pierrotm777/SoundModule_Teensy4.0-version/README.md

# Multi Sounds for RC boat (or Truck, Tank, Car and Plane)

## Credits
Based on a croby-b's code idea and powered by Rc-Navy libraries.  

## Outline of the documentation
1. Introduction (this page)
1. [Xany Compatibility](Xany_Compatibility.md)
1. [Xany Serial Commands](Xany_Mode.md)
1. [Buttons Serial Commands](Buttons_Mode.md)
1. [Wiring Sound module](Wiring_Module.md)
1. [Sd Card Structure](SD_Card_Structure.md)

## Introduction
For build this module we use the [Teensy-Variable-Playback](https://github.com/newdigate/teensy-variable-playback) library with a Teensy 4.0.  

This Sound Module is primarily intended for model boats, trucks, tractors, tanks, and backhoe loaders, but can also be configured for aircraft.  

This module can:  
- vary the engine sound based on engine speed.  
- use any type of engine sound (more than 10 are already available).  
- 4 simultaneous sounds in addition to the engine sound.  
- 16 pre-programmable sounds.  
- 4 pre-programmable random sounds.  
- volume control via the touchscreen, a button on the transmitter, or two buttons on a 10-button keypad.  
- Smoke system management (tank + air pump).  
- 5 RGB LEDs (multicolored).  
- Controllable via touchscreen or 10-button keypad.  
- 2W audio amplifier (useful for small boats or testing) or 18W.  
- Controllable via a receiver with PWM, CPPM, SBUS (Frsky or others), IBUS (Flysky), SRXL (Multiplex), SUMD (Graupner), JETI, or CRSF (ExpressLRS/TBS) output.  
- ESC output management to adjust engine sound (adjustable acceleration and deceleration).  
- 4 alarms, one of which is reversible to detect the absence of liquid, for example.  
- Telemetry feedback of the Teensy's temperature as well as the motor battery voltage for Frsky (Hub or S-Port), Flysky (Ibus), ExpressLRS/TBS (CRSF).  
- Module management/configuration via its serial interface.  
- Module configuration backup on an SD card.  

SD Card:  
- This contains all the sounds and the sound module's configuration.  

Power Supply:  
The module is powered by a Lipo battery for a maximum of 2s to 3s.  
It is possible to enable or disable the module's power supply using a relay or other solution via the On/Off connector.  

A custom printed circuit board has been created. We are currently at version v1.2, visible above.  
A v1.3 version is planned, which will include an additional option via an I2C interface.  
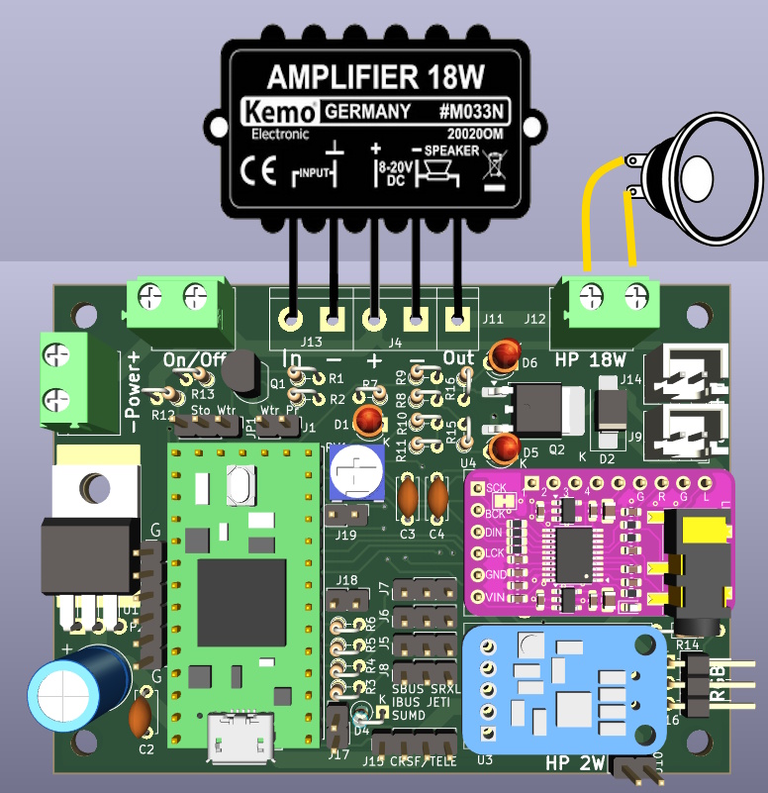
[picture p1: ampli18w.jpg]
  

Creating a new engine sound:  
Simply retrieve the desired engine sound to create a startup sound, an operating sound, and a shutdown sound.  
The more realistic the original sound, the more appealing the result will be.  
So, when the engine starts, you hear the typical sound of an engine hesitating, followed by the normal sound with variations in frequency and speed.  
Then, when the engine stick returns to center, after 5 to 10 seconds (adjustable), the shutdown sound is played.  

## Two modes
Two modes are possibles:
- Use [X-Any/BURC encoder](https://p-loussouarn-free-fr.translate.goog/arduino/exemple/RCUL/RCUL.html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) fonctions by RC-Navy, thanks to him.  
- Use [Buttons Keypad](http://p.loussouarn.free.fr/projet/MS8-V2/MS8-V2.html#Keyboard) fonctions by RC-Navy, thanks to him.  
- The module read all WAV sounds from a SD card (from /ENGINES folder).  

You can find more informations on the Sound Module:
- [french manual](https://github.com/pierrotm777/SoundModule_Teensy4.0-version/blob/main/Module_Son_Manuel_Utilisateur.pdf).  
- [english manual (TODO)](https://github.com/pierrotm777/SoundModule_Teensy4.0-version/blob/main/Module_Son_Manuel_Utilisateur.pdf).    

### X-Any mode
This mode decode the X-Any/BURC stream.  

Depending on the receiver used, it's possible to connect the sound module in different ways:  
- PWM  
- CPPM  
- SBUS (without inverter)  
- IBUS  
- SUMD  
- SRXL  
- JETIEX  
- CRSF  

A [BURC encoder](https://github.com/pierrotm777/BURC_Encoder) or a [LVGL ESP32 S3 Screen](https://github.com/pierrotm777/ESP32-BURC-Screen) is connected on a Handset by CPPM or SBUS.     

These X-Any/BURC coder use the **trainer port** as slave and use up to 2 channels (for the Sound Module) as X-Any fonctions.  
X-Any inject three additionals RC channels to a CPPM or SBUS frame for transport messages over these additionals channels.  
At reception side, these messages are extracted from these 2 channels corresponding to the additionals channels.  
These 2 channels are used to transport 2 messages containing the status of a set of switches or set of sound in the Sound Modul case.  

### Buttons mode
This mode use a keyboard with 10 buttons (8 buttons + 2 for volume sounds).  
It's a good solution for old rc transmitters that do not have a training input.  
This keyboard is connected on a free input channel in place of a potentiometer.  
This mode accept only 8 sounds.  
The buttons 9 and 10 up or down the volume's sounds.  

<table cellspacing=0>
  <tr>
    <td align=center width=400><a href="https://github.com/pierrotm777/SoundModule_Teensy4.0-version/blob/main/10ButtonsKeyboard.md">Sound Module</a><br><b>KeyBoard 10 buttons</td>
  </tr>
</table>

Depending on the receiver used, it's possible to connect the sound module in different ways:  
- PWM  
- CPPM  
- SBUS (without inverter)  
- IBUS  
- SUMD  
- SRXL  
- JETIEX  
- CRSF  

## PCB versions
<table cellspacing=0>
  <tr>
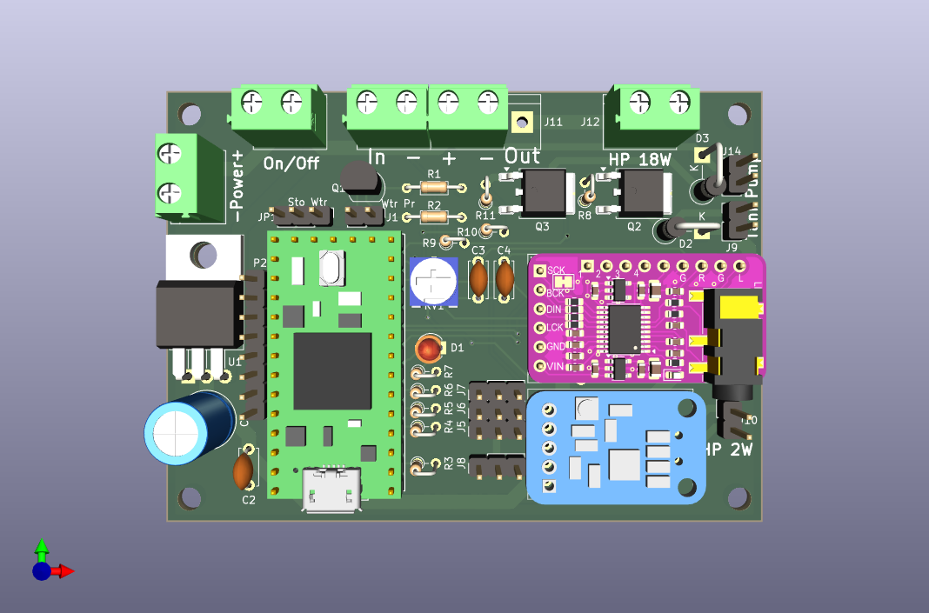
[picture p2: Hardware/V1.0/Sound_Myca_Teensy-Top3d_v1.0.png]
Sound Module v1.0 Sound Module
    <td align=center width=400><br><b>V1.0 (deprecated)</td>
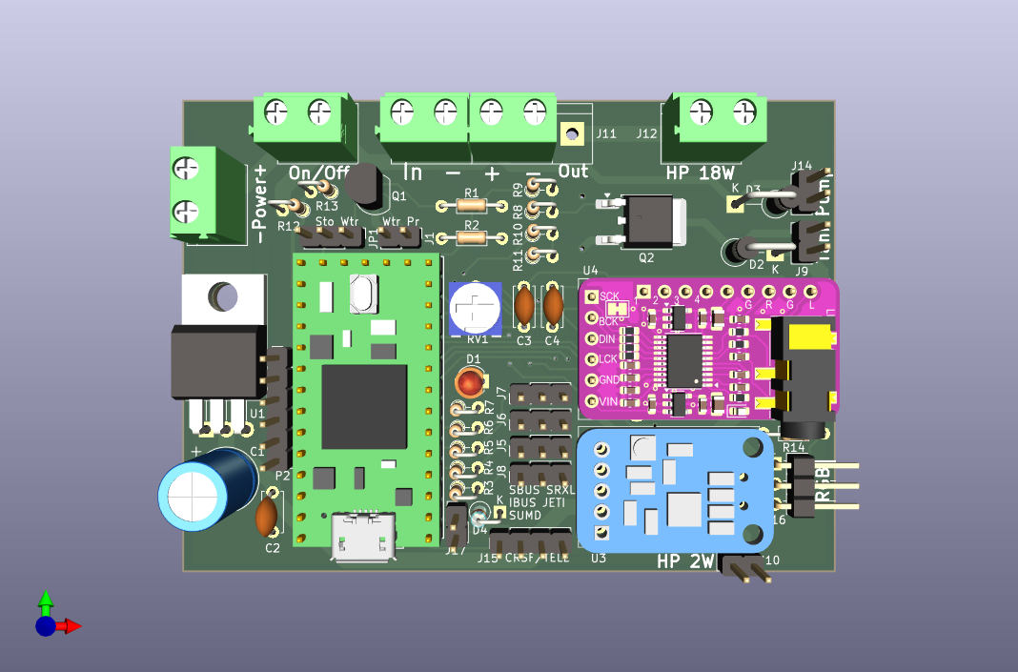
[picture p3: Hardware/V1.1/Sound_Myca_Teensy_Top_v1.1.png]
Sound Module v1.1 Sound Module
    <td align=center width=400><br><b>V1.1 (deprecated)</td>
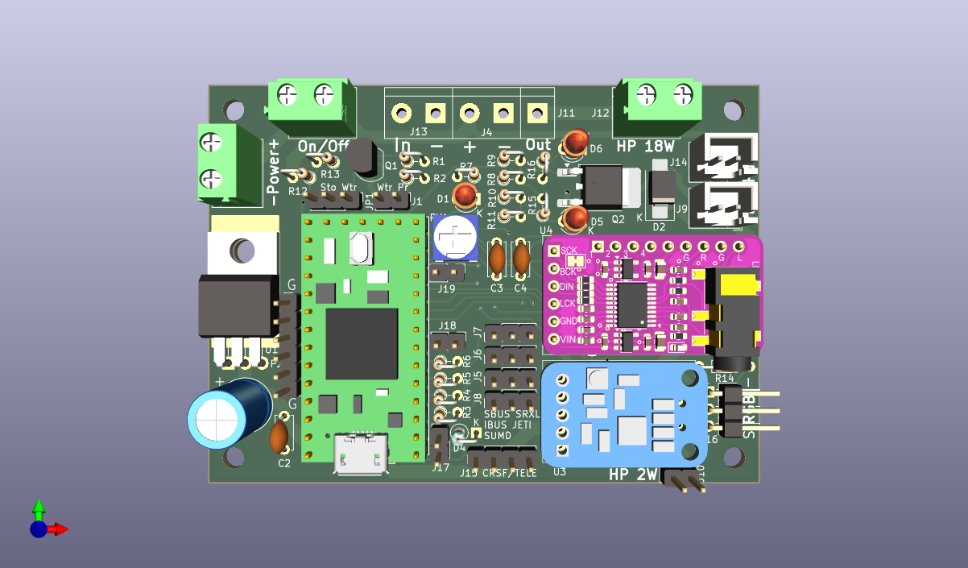
[picture p4: Hardware/V1.2/Sound_Myca_Teensy_Top_v1.2.png]
Sound Module v1.2 Sound Module
    <td align=center width=400><br><b>V1.2</td>
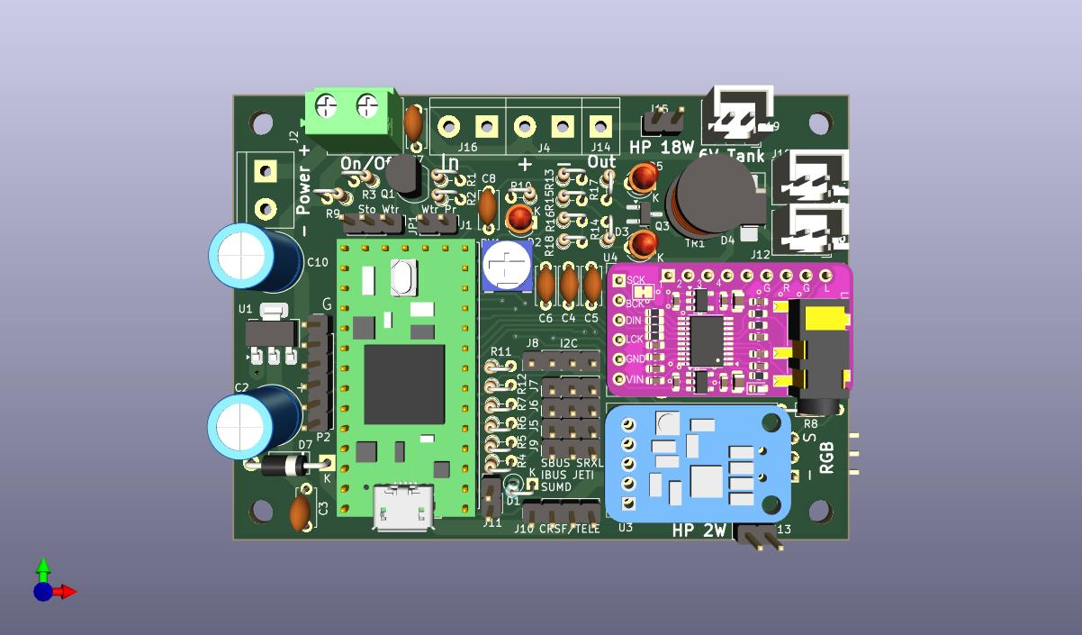
[picture p5: Hardware/V1.3/Sound_Myca_Teensy_Top.jpg]
Sound Module v1.3 Sound Module
	<td align=center width=400><br><b>V1.3</td>
  </tr>
</table>

## WAV Sounds
Play **16-bit PCM 44100Hz Stereo** WAV audio samples at variable playback rates on Teensy.  
- Note : this library only works with signed 16-bit integer samples. Floating point samples will not play.  
- For best performance, use SDXC UHS 30MB/sec Application Performance Class 2 (A2) class micro SD-card.  

### Sounds Motor
It's possible to select several motors.  
The module can list all sound's motor found into the SD card [ENGINES folder](https://github.com/pierrotm777/SoundModule_Teensy4.0-version/tree/main/SD_Wav_Files/ENGINES).  
**ENG.LIST = DSL-LTL, DSL-V12, VAPEUR, DSL-OLD, DSL-120, DSL-TURB, DSL-TUG, SCAN-V12, DSL-BIG, DSL-180, DIESEL7, SCAN-250, CAT-C32, BF109**  
Each motor use:  
- A start file, ex:DSL-LTL_STA.  
- An idle file, ex:DSL-LTL_IDL.  
- A stop file, ex:DSL-LTL_STP.  

It's possible to add new motor's sounds.  
The better way, for me, is to use [Audacity](https://www.audacityteam.org) for cut all sound find and save it as 16bits PCM 44100Hz wav file.  

### All other sounds
All other other sounds will have to be copied under the main path.  
See our sounds [here](https://github.com/pierrotm777/SoundModule_Teensy4.0-version/tree/main/SD_Wav_Files).  
You can change the **USER1.wav to USER15.wav by your own sounds**.  
USER16.wav is used as alarms sound.  

## Upload a firmware
Only one firmware for all features:
1. For PCB v1.2:  
  - [teensy_sound_Xany_V3_9.hex](https://github.com/pierrotm777/SoundModule_Teensy4.0-version/blob/main/Firmware/teensy_sound_Xany_V3_9-v1.2.hex)  
1. For PCB v1.3:
  - [teensy_sound_Xany_V3_9.hex](https://github.com/pierrotm777/SoundModule_Teensy4.0-version/blob/main/Firmware/teensy_sound_Xany_V3_9-v1.3.hex)  
For upload a firmware into the Teensy you must to use the [Teensy Loader](https://github.com/pierrotm777/SoundModule_Teensy4.0-version/tree/main/Firmware/Teensy_Uploader.zip).  

# New features

## Wifi feature
With the v1.2 and v1.3 PCB versions, it's now possible to obtain several informations from the sound module.  
For use this option, we need to add a little [ESP32C3 LCD board](https://www.google.com/search?client=firefox-b-d&q=ESP32C3+LCD) connected to the Teensy bu a serial port.  
This board use the ESPNOW protocol for communicate with the [ESP32 coder](https://github.com/pierrotm777/ESP32-BURC-Screen) screen.  
See [here]() for more informations.  

## Temperatures feature
With the v1.2 and v1.3 PCB versions, it's now possible to send telemetry to a RC transmitter.  
Three sensors are simulated:
  - Battery of your model, (by default 3S with R12=33K (PCB v1.2) or R9=33K (PCB v1.3).  
  - Teensy temperature (no need specific hardware).  
  - Tank temperature (need to connect a DS18B20 to Teensy pin 27, GND and 3.3v).  
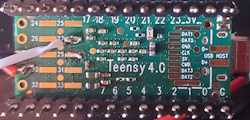
[picture p6: ds18b20_Teensy.jpg]
   
  Versions telemetries usable are:
    - S-PORT (D16 Frsky)  
    - HUB (old D8 Frsky)  
    - IBUS   
    - MLINK  
    - HOTT  
    - JETIEX  
    - CRSF
