pierrotm777/SoundModule_Teensy4.0-version/Smoke_System.md

# Smoke system
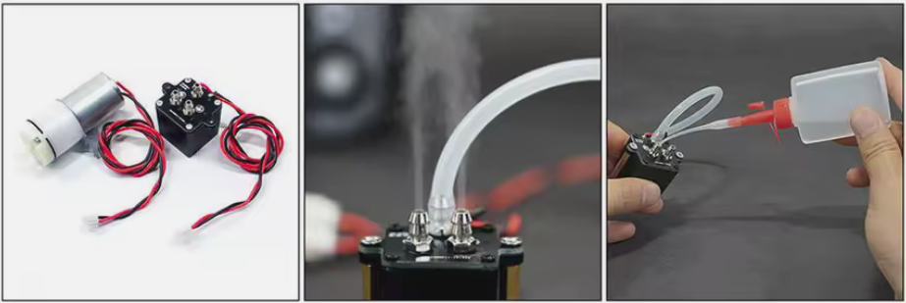
[picture p8: Smoke_System.png]
  

## How to use the tank with the pump
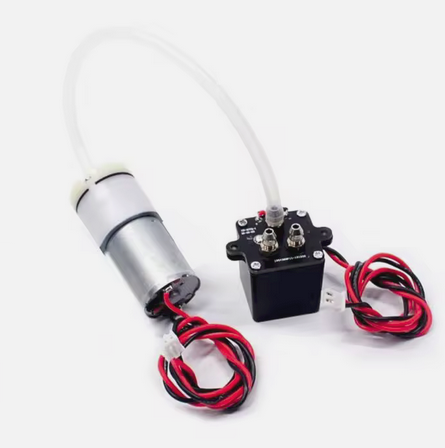
[picture p9: Smoke&Blower.png]
  

## Wiring smoke system to the module
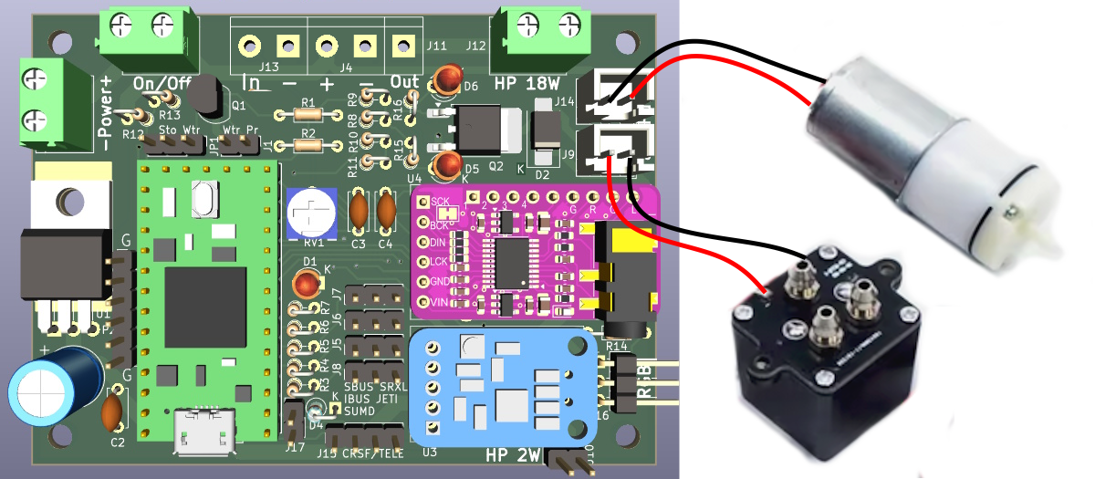
[picture p10: Module&Smoke&Blower.png]
  

## Smoke Filling
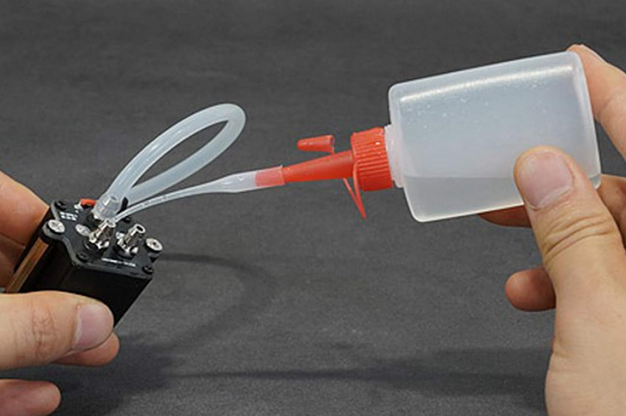
[picture p11: Smoke_Filling.png]
