pierrotm777/SoundModule_Teensy4.0-version/Xany_Compatibility.md

## Xany Compatibility
All RC systems should be compatible with the Xany protocol.  

### Usable systems with Xany
Xany Operational Report:  
All tests were performed with a Teensy 4.0 and Xany2Spy sw=8 and sw=16.  

### REGLAGES ENSEMBLE CODEUR/DECODEUR BURC POUR DIFFERENTS EMETTEURS/RECEPTEURS
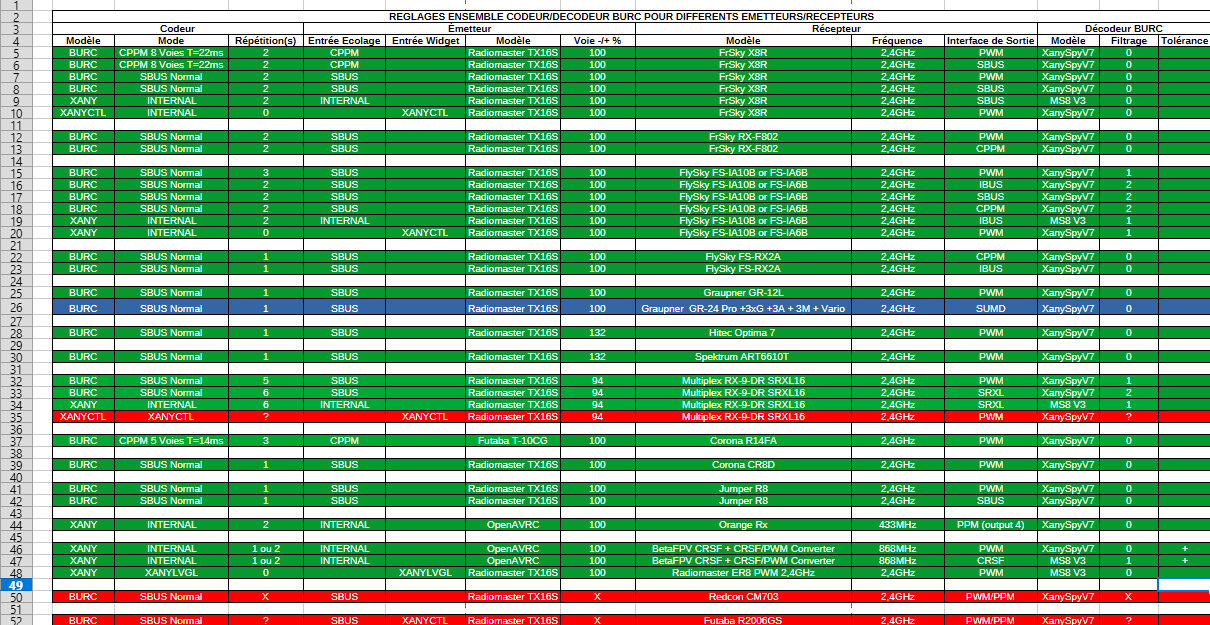
[picture p12: RculXanyTests_V1.png]
