pierrotm777/SoundModule_Teensy4.0-version/Four_Alarms_System.md

# Alarms system
4 Alarms with the first usable for check if a tank is empty.  

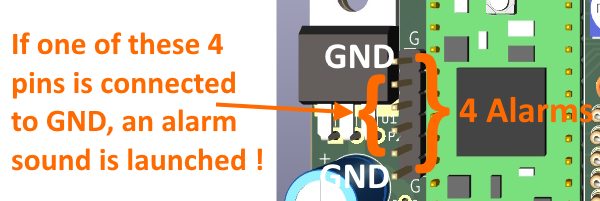
[picture p29: Use_4Alarms.png]
