pierrotm777/SoundModule_Teensy4.0-version/pam8302_pcb.png

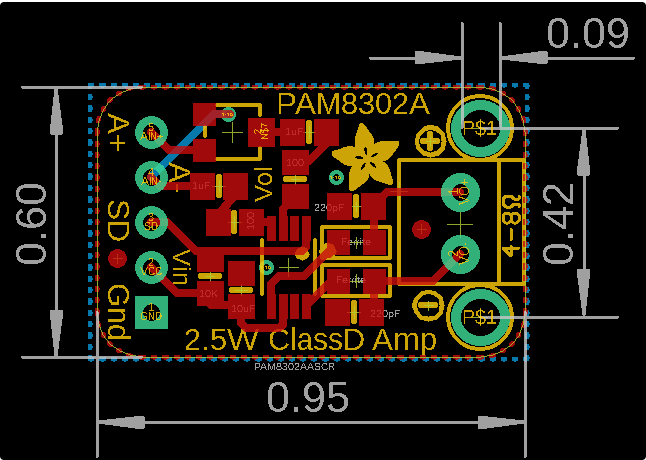
pam8302_pcb.png
