pierrotm777/SoundModule_Teensy4.0-version/Smoke_Pump&Tank.png

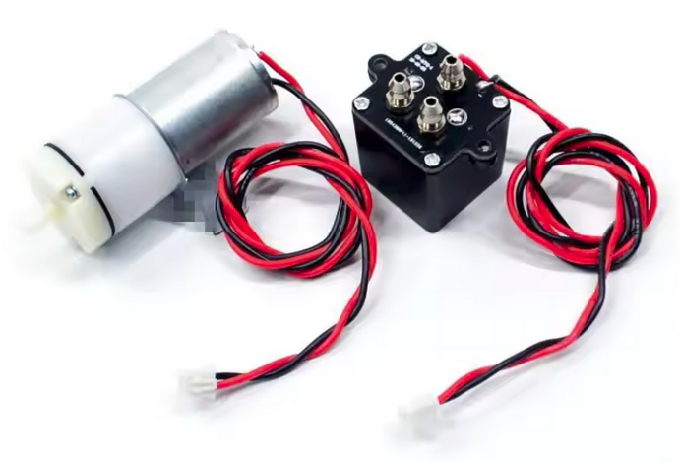
Smoke_Pump&Tank.png
