pierrotm777/SoundModule_Teensy4.0-version/Smoke_Shematic.png

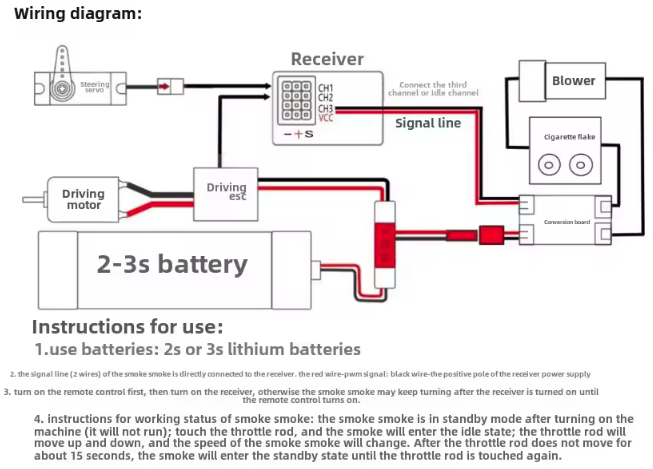
Smoke_Shematic.png
