pierrotm777/SoundModule_Teensy4.0-version/Sound_Myca_Teensy-Bot3d.png

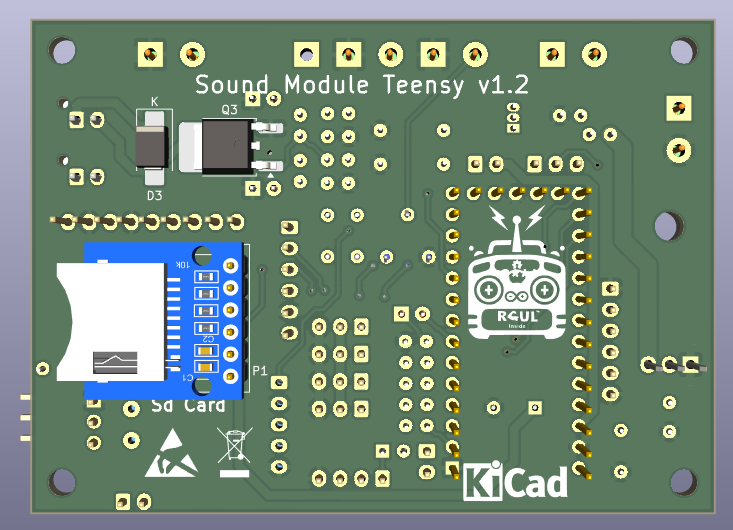
Sound_Myca_Teensy-Bot3d.png
