pierrotm777/SoundModule_Teensy4.0-version/Sound_Teensy-Top3d.png

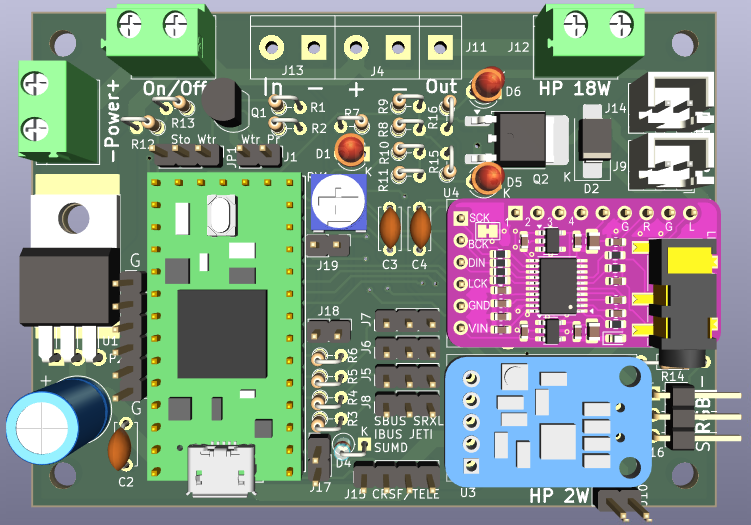
Sound_Teensy-Top3d.png
