pierrotm777/SoundModule_Teensy4.0-version/Tank.png

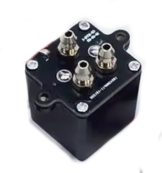
Tank.png
