pierrotm777/SoundModule_Teensy4.0-version/Termite.png

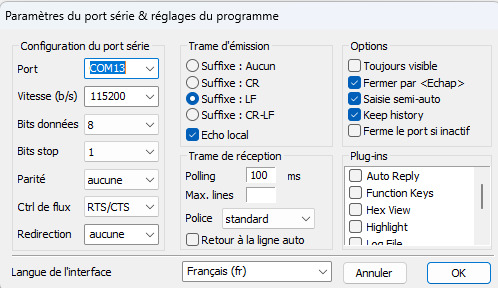
Termite.png
