pierrotm777/SoundModule_Teensy4.0-version/Receiver_Wiring.md

# Wiring between module and a RC receiver
  

## CPPM, SBUS, IBUS, SUMD, SRXL, JETI, CRSF
Use J8 connector.   
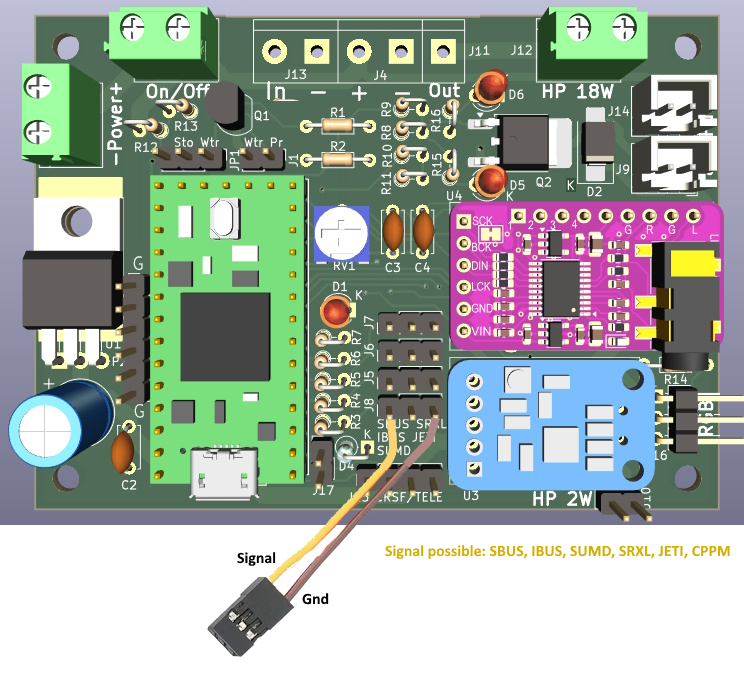
[picture p45: Receiver_SBUS.png]
  

## CRSF
Use J5 connector.    
