pierrotm777/SoundModule_Teensy4.0-version/Wiring_Module.md

# Wiring the Sound Module

## Wiring description 
<table cellspacing=0>
  <tr>
    <td align=center width=400><a href="https://github.com/pierrotm777/SoundModule_Teensy4.0-version/blob/main/All_Wirings.md">Sound Module v1.0 Sound Module</a><br><b>All connections</td>
  </tr>
</table>

## Wiring to Power 2s or 3s 
<table cellspacing=0>
  <tr>
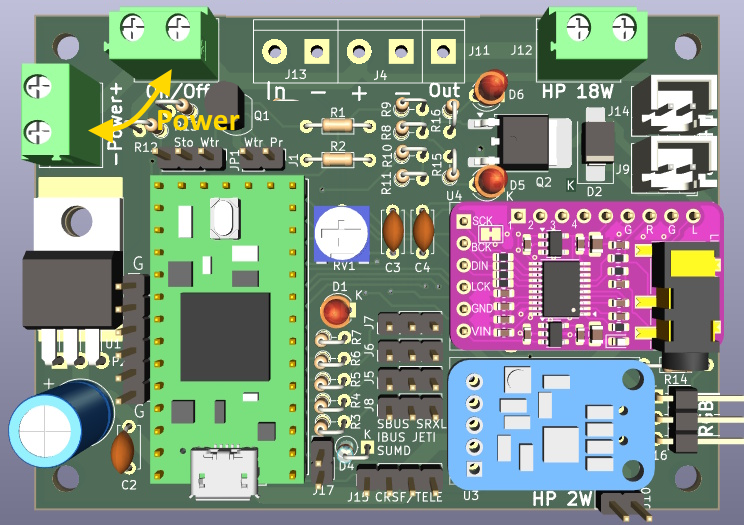
[picture p46: Power_Wiring.png]
    <td align=center width=400><br><b>All connections</td>
  </tr>
</table>

## Wiring Amplifier 18W KEMO M033N
<table cellspacing=0>
  <tr>
    <td align=center width=400><a href="https://github.com/pierrotm777/SoundModule_Teensy4.0-version/blob/main/Kemo_MN033N.md">Sound Module v1.0 Sound Module</a><br><b>Kemo M033N</td>
  </tr>
</table>

## Wiring Smoke system
<table cellspacing=0>
  <tr>
    <td align=center width=400><a href="https://github.com/pierrotm777/SoundModule_Teensy4.0-version/blob/main/Smoke_System.md">Smoke System Sound Module</a><br><b>Smoke System</td>
  </tr>
</table>

## Wiring Water Empty Alarm
<table cellspacing=0>
  <tr>
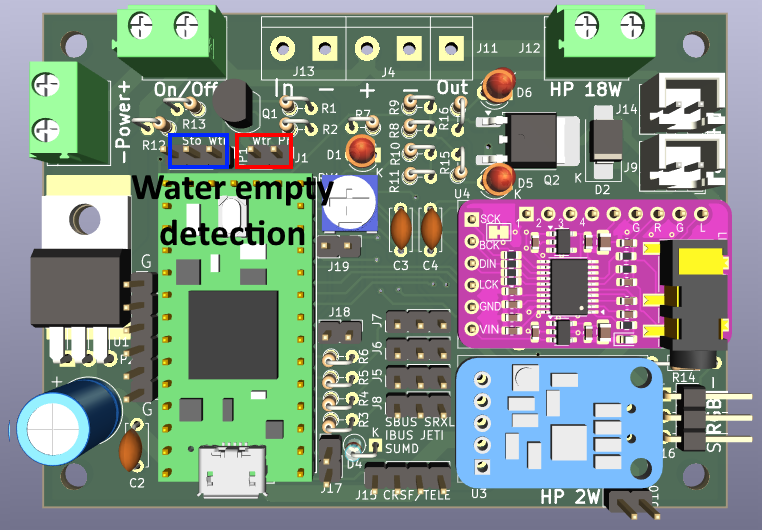
[picture p47: Water_Empy_Detection.png]
Water's Tank Alarm Sound Module
    <td align=center width=400><br><b>Water's Tank Alarm</td>
  </tr>
</table>

## 4 Alarms
<table cellspacing=0>
  <tr>
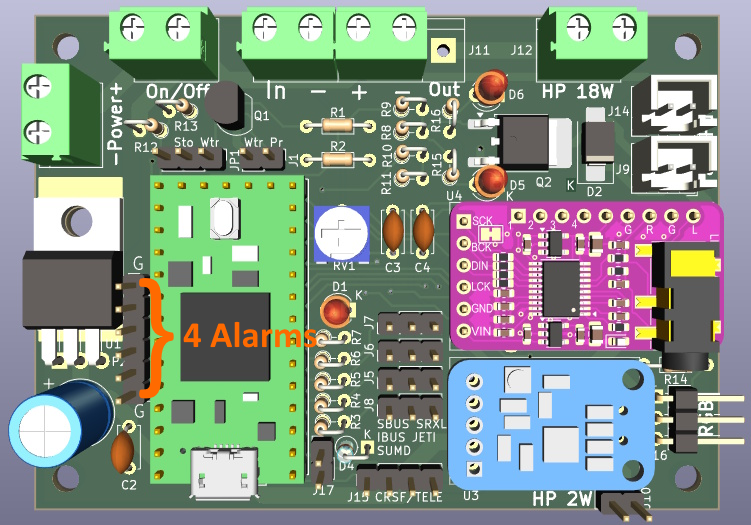
[picture p48: Four_Alarms_System.png]
Soke System Sound Module
    <td align=center width=400><br><b>Four System Alamrs</td>
  </tr>
</table>

## Wiring with receiver
<table cellspacing=0>
  <tr>
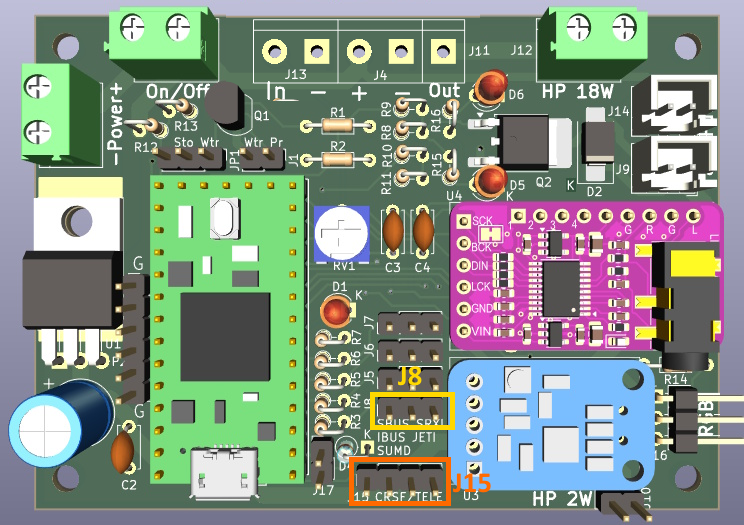
[picture p49: SBUS_CRSF_Telemetry.png]
    <td align=center width=400><br><b>Four System Alamrs</td>
  </tr>
</table>

## Receiver Telemetry
<table cellspacing=0>
  <tr>
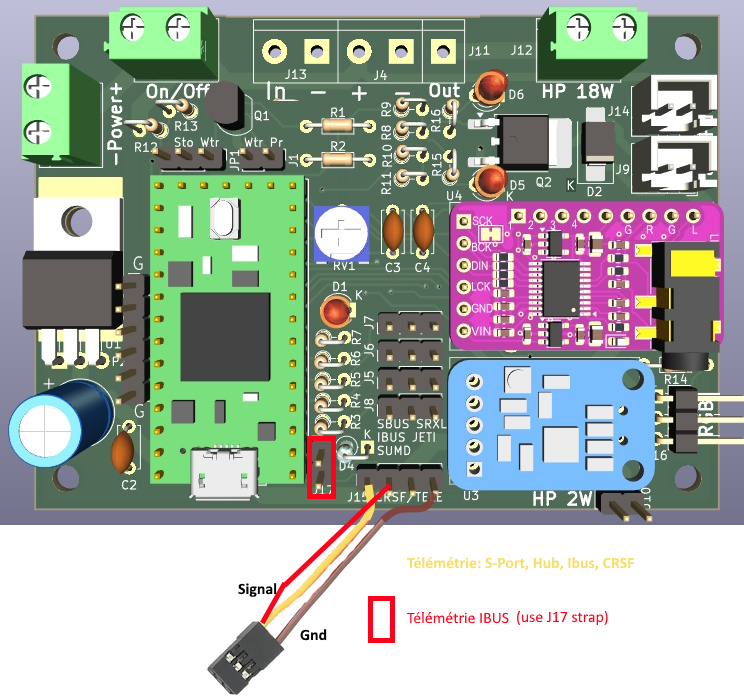
[picture p50: Receiver_Telemetry.png]
    <td align=center width=400><br><b>Telemetry</td>
  </tr>
</table>
