pierrotm777/SoundModule_Teensy4.0-version/Power_Wiring.md

# Power module's wiring
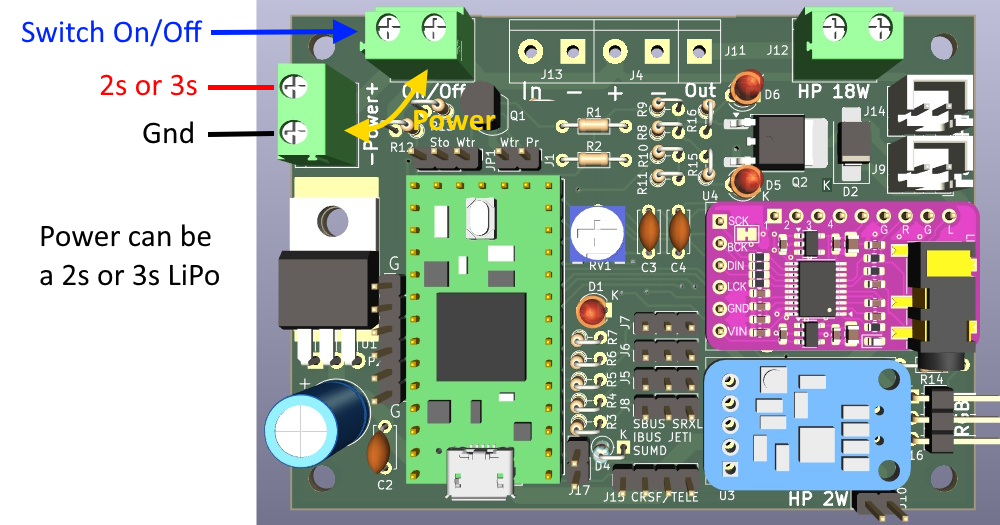
[picture p51: Power_Wiring2.png]
