pierrotm777/SoundModule_Teensy4.0-version/RculXanyTests_V1.pdf

REGLAGES ENSEMBLE CODEUR/DECODEUR BURC POUR DIFFERENTS EMETTEURS/RECEPTEURS
Codeur | Émetteur | Récepteur | Décodeur BURC
Modèle | Mode | Répétition(s) | Entrée Ecolage | Entrée Widget | Modèle | Voie -/+ % | Modèle | Fréquence | Interface de Sortie | Modèle | Filtrage | Tolérance
BURC | CPPM 8 Voies T=22ms | 2 | CPPM | | Radiomaster TX16S | 100 | FrSky X8R | 2,4GHz | PWM | XanySpyV7 | 0
BURC | CPPM 8 Voies T=22ms | 2 | CPPM | | Radiomaster TX16S | 100 | FrSky X8R | 2,4GHz | SBUS | XanySpyV7 | 0
BURC | SBUS Normal | 2 | SBUS | | Radiomaster TX16S | 100 | FrSky X8R | 2,4GHz | PWM | XanySpyV7 | 0
BURC | SBUS Normal | 2 | SBUS | | Radiomaster TX16S | 100 | FrSky X8R | 2,4GHz | SBUS | XanySpyV7 | 0
XANY | INTERNAL | 2 | INTERNAL | | Radiomaster TX16S | 100 | FrSky X8R | 2,4GHz | SBUS | MS8 V3 | 0
XANYCTL | INTERNAL | 0 | | XANYCTL | Radiomaster TX16S | 100 | FrSky X8R | 2,4GHz | PWM | XanySpyV7 | 0
BURC | SBUS Normal | 2 | SBUS | Radiomaster TX16S | 100 | FrSky RX-F802 | 2,4GHz | PWM | XanySpyV7 | 0
BURC | SBUS Normal | 2 | SBUS | Radiomaster TX16S | 100 | FrSky RX-F802 | 2,4GHz | CPPM | XanySpyV7 | 0
BURC | SBUS Normal | 3 | SBUS | | Radiomaster TX16S | 100 | FlySky FS-IA10B or FS-IA6B | 2,4GHz | PWM | XanySpyV7 | 1
BURC | SBUS Normal | 2 | SBUS | | Radiomaster TX16S | 100 | FlySky FS-IA10B or FS-IA6B | 2,4GHz | IBUS | XanySpyV7 | 2
BURC | SBUS Normal | 2 | SBUS | | Radiomaster TX16S | 100 | FlySky FS-IA10B or FS-IA6B | 2,4GHz | SBUS | XanySpyV7 | 2
BURC | SBUS Normal | 2 | SBUS | | Radiomaster TX16S | 100 | FlySky FS-IA10B or FS-IA6B | 2,4GHz | CPPM | XanySpyV7 | 2
XANY | INTERNAL | 2 | INTERNAL | | Radiomaster TX16S | 100 | FlySky FS-IA10B or FS-IA6B | 2,4GHz | IBUS | MS8 V3 | 1
XANY | INTERNAL | 0 | | XANYCTL | Radiomaster TX16S | 100 | FlySky FS-IA10B or FS-IA6B | 2,4GHz | PWM | XanySpyV7 | 1
BURC | SBUS Normal | 1 | SBUS | Radiomaster TX16S | 100 | FlySky FS-RX2A | 2,4GHz | CPPM | XanySpyV7 | 0
BURC | SBUS Normal | 1 | SBUS | Radiomaster TX16S | 100 | FlySky FS-RX2A | 2,4GHz | IBUS | XanySpyV7 | 0
BURC | SBUS Normal | 1 | SBUS | Radiomaster TX16S | 100 | Graupner GR-12L | 2,4GHz | PWM | XanySpyV7 | 0
BURC | SBUS Normal | 1 | SBUS | Radiomaster TX16S | 100 | Graupner GR-24 Pro +3xG +3A + 3M + Vario | 2,4GHz | SUMD | XanySpyV7 | 0
BURC | SBUS Normal | 1 | SBUS | Radiomaster TX16S | 132 | Hitec Optima 7 | 2,4GHz | PWM | XanySpyV7 | 0
BURC | SBUS Normal | 1 | SBUS | Radiomaster TX16S | 132 | Spektrum ART6610T | 2,4GHz | PWM | XanySpyV7 | 0
BURC | SBUS Normal | 5 | SBUS | | Radiomaster TX16S | 94 | Multiplex RX-9-DR SRXL16 | 2,4GHz | PWM | XanySpyV7 | 1
BURC | SBUS Normal | 6 | SBUS | | Radiomaster TX16S | 94 | Multiplex RX-9-DR SRXL16 | 2,4GHz | SRXL | XanySpyV7 | 2
XANY | INTERNAL | 6 | INTERNAL | | Radiomaster TX16S | 94 | Multiplex RX-9-DR SRXL16 | 2,4GHz | SRXL | MS8 V3 | 1
XANYCTL | XANYCTL | ? | | XANYCTL | Radiomaster TX16S | 94 | Multiplex RX-9-DR SRXL16 | 2,4GHz | PWM | XanySpyV7 | ?
BURC | CPPM 5 Voies T=14ms | 3 | CPPM | Futaba T-10CG | 100 | Corona R14FA | 2,4GHz | PWM | XanySpyV7 | 0
BURC | SBUS Normal | 1 | SBUS | Radiomaster TX16S | 100 | Corona CR8D | 2,4GHz | PWM | XanySpyV7 | 0
BURC | SBUS Normal | 1 | SBUS | Radiomaster TX16S | 100 | Jumper R8 | 2,4GHz | PWM | XanySpyV7 | 0
BURC | SBUS Normal | 1 | SBUS | Radiomaster TX16S | 100 | Jumper R8 | 2,4GHz | SBUS | XanySpyV7 | 0
XANY | INTERNAL | 2 | INTERNAL | OpenAVRC | 100 | Orange Rx | 433MHz | PPM (output 4) | XanySpyV7 | 0
XANY | INTERNAL | 1 ou 2 | INTERNAL | | OpenAVRC | 100 | BetaFPV CRSF + CRSF/PWM Converter | 868MHz | PWM | XanySpyV7 | 0 | +
XANY | INTERNAL | 1 ou 2 | INTERNAL | | OpenAVRC | 100 | BetaFPV CRSF + CRSF/PWM Converter | 868MHz | CRSF | MS8 V3 | 1 | +
XANY | XANYLVGL | 0 | | XANYLVGL | Radiomaster TX16S | 100 | Radiomaster ER8 PWM 2,4GHz | 2,4GHz | PWM | MS8 V3 | 0
BURC | SBUS Normal | X | SBUS | | Radiomaster TX16S | X | Redcon CM703 | 2,4GHz | PWM/PPM | XanySpyV7 | X
BURC | SBUS Normal | ? | SBUS | XANYCTL | Radiomaster TX16S | X | Futaba R2006GS | 2,4GHz | PWM/PPM | XanySpyV7 | ?
| X-Any Ready | | Not tested | | | Not compatible
