pierrotm777/SoundModule_Teensy4.0-version/Hardware/V1.3/Sound_Myca_Teensy_v1.3.pdf

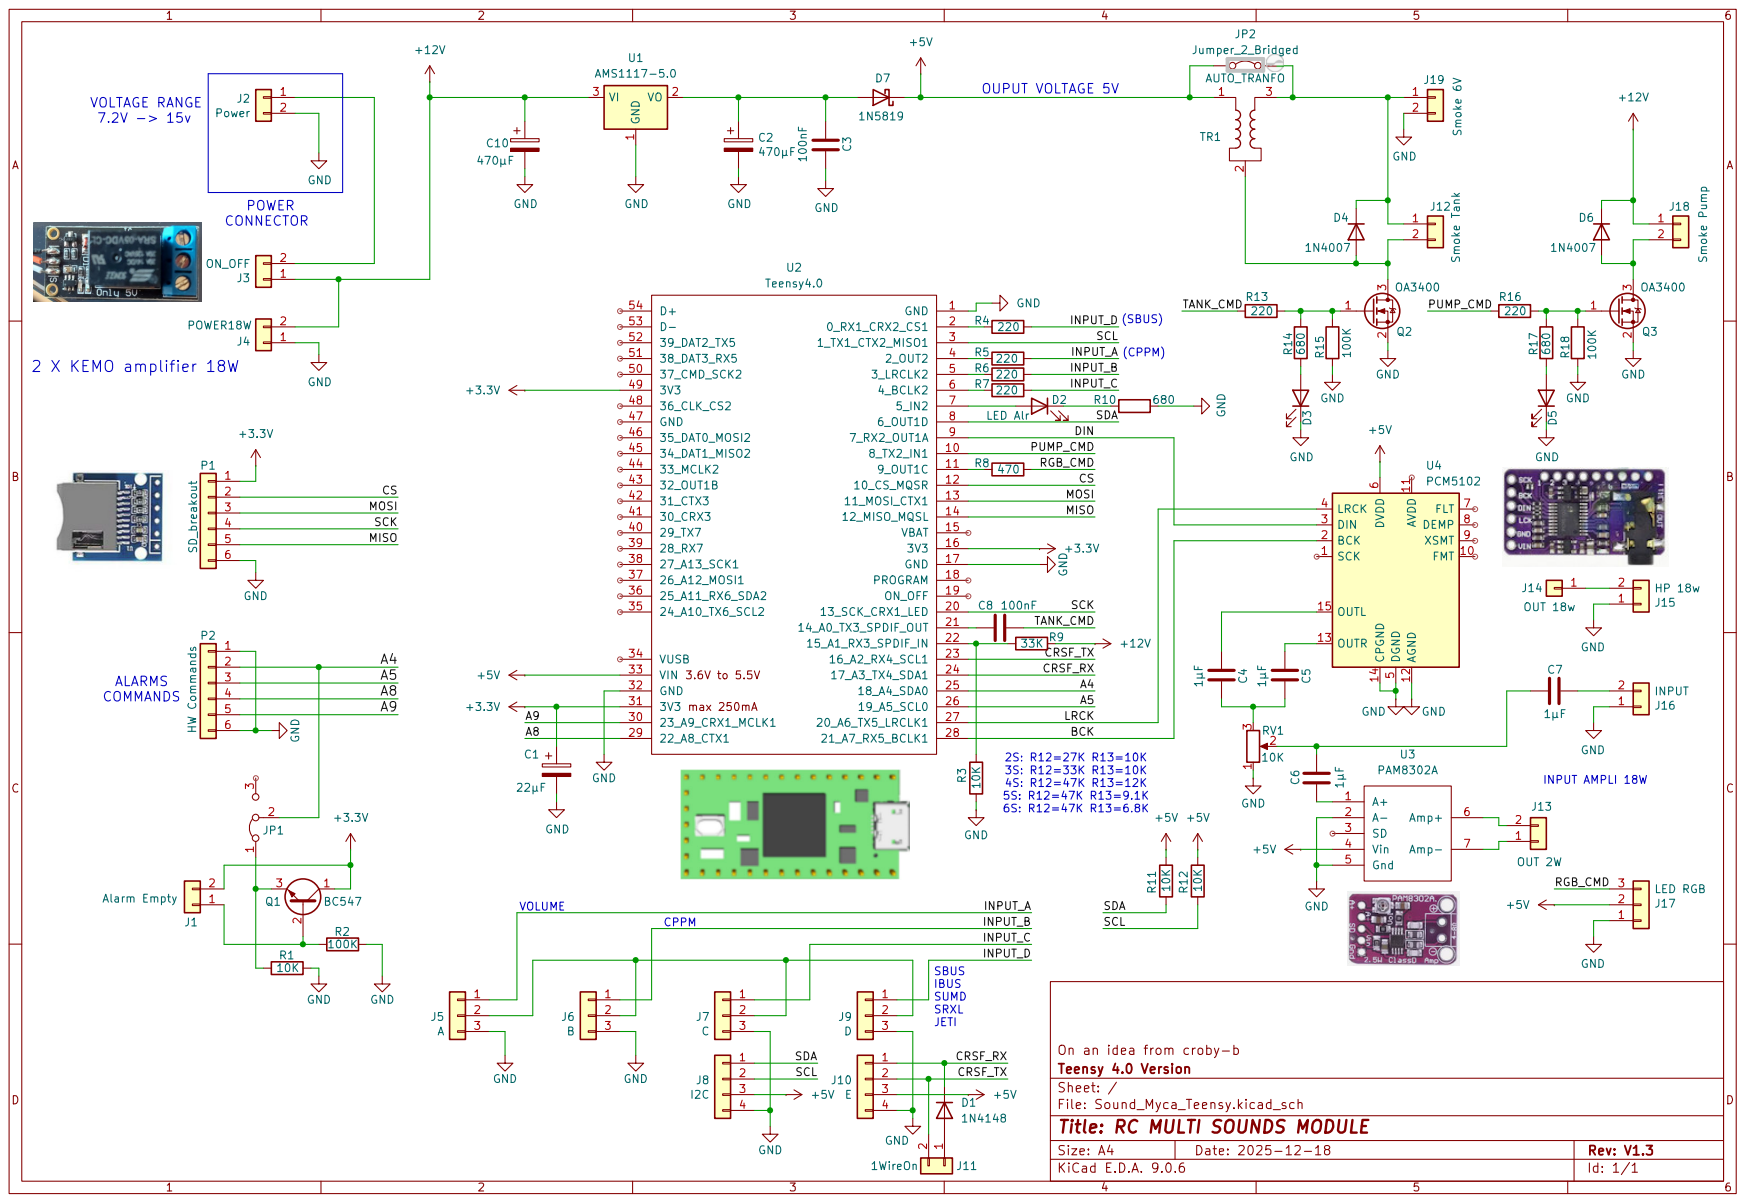
[picture p52: page 1]
