pierrotm777/SoundModule_Teensy4.0-version/Hardware/Sound_Myca_Teensy.kicad_pcb

## KiCad design Hardware/Sound_Myca_Teensy.kicad_pcb (2025-02-10, last stored version)

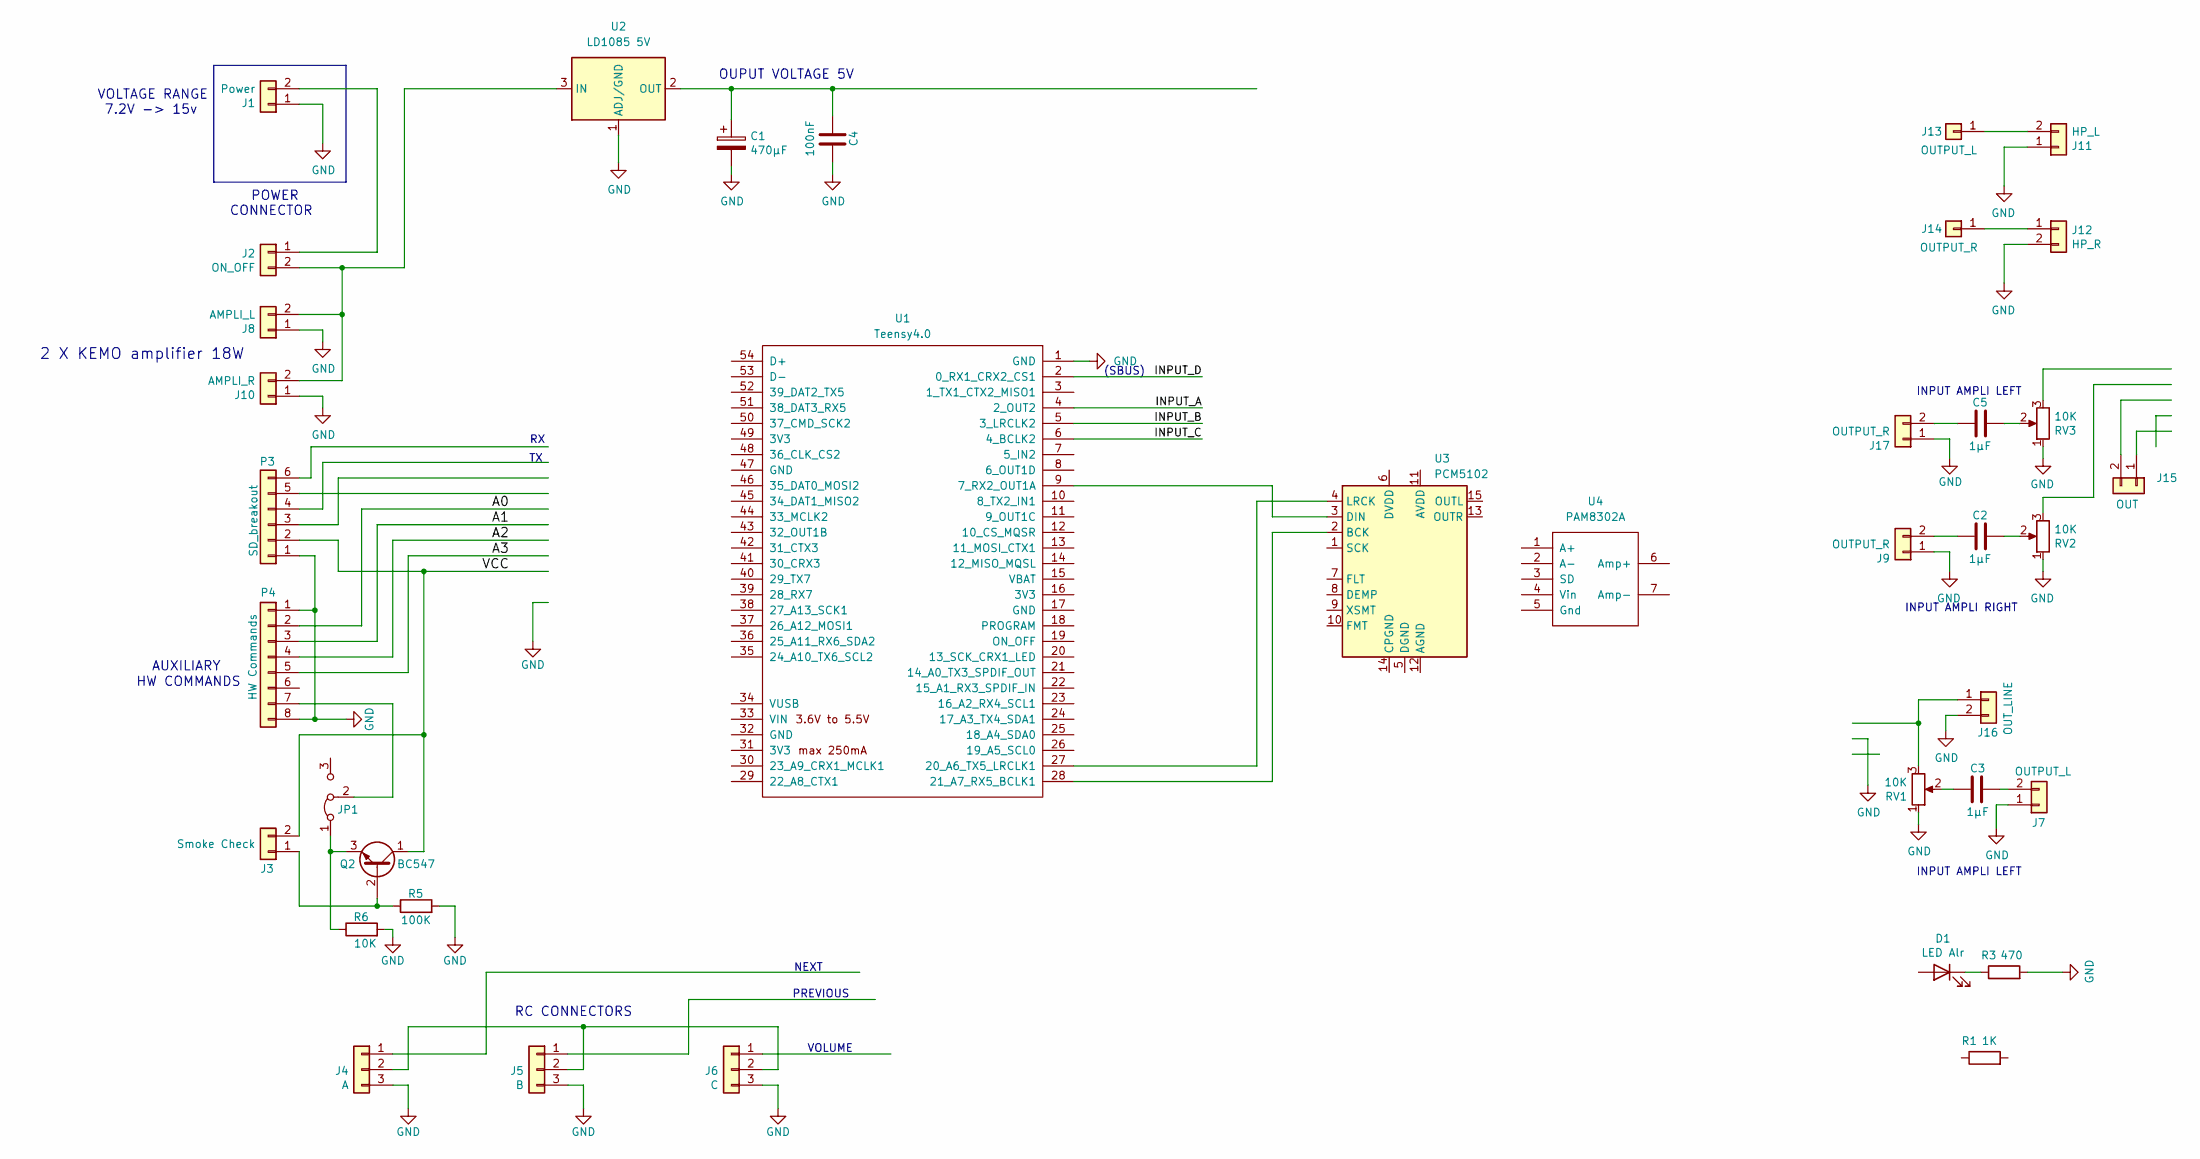
[picture p53: schematic Sound_Myca_Teensy.kicad_sch, RC SOUND MODULE]

Parts:
C1: 470µF; C_Radial_D8.0mm_H11.5mm_P3.50mm
C2, C3, C5: 1µF; C_Disc_D5.0mm_W2.5mm_P5.00mm
C4: 100nF; C_Disc_D5.0mm_W2.5mm_P5.00mm
D1: LED Alr; LED_D3.0mm
J1: Power; bornier2
J2: ON_OFF; bornier2
J3: Smoke Check; PinHeader_1x02_P2.54mm_Vertical
J4: A; PinHeader_1x03_P2.54mm_Vertical
J5: B; PinHeader_1x03_P2.54mm_Vertical
J6: C; PinHeader_1x03_P2.54mm_Vertical
J7: OUTPUT_L; bornier2
J8: AMPLI_L; bornier2
J9, J17: OUTPUT_R; bornier2
J10: AMPLI_R; bornier2
J11: HP_L; bornier2
J12: HP_R; bornier2
J13: OUTPUT_L; bornier1
J14: OUTPUT_R; bornier1
J15: OUT; PinHeader_2x01_P2.54mm_Vertical
J16: OUT_LINE; PinHeader_2x01_P2.54mm_Vertical
JP1: Jumper_2_Open; PinHeader_1x03_P2.54mm_Vertical
P3: SD_breakout; SD_BREAKOUT_MINI
P4: HW Commands; PinHeader_1x08_P2.54mm_Vertical
Q2: BC547; TO-92_Inline
R1: 1K; R_Axial_DIN0204_L3.6mm_D1.6mm_P7.62mm_Horizontal
R3: 470; R_Axial_DIN0204_L3.6mm_D1.6mm_P7.62mm_Horizontal
R5: 100K; R_Axial_DIN0204_L3.6mm_D1.6mm_P7.62mm_Horizontal
R6: 10K; R_Axial_DIN0204_L3.6mm_D1.6mm_P7.62mm_Horizontal
RV1, RV2, RV3: 10K; Potentiometer_Round_5.08x5.08_Vertical
U1: Teensy4.0; Teensy40
U2: LD1085 5V; TO-220-3_Horizontal_TabDown
U3: PCM5102; pcm5102
U4: PAM8302A; pam8302a

Connections:
/A0: P4.2
/A1: P4.3
/A2: P4.4
/A3: P4.5
/INPUT_A: U1.4 (2_OUT2)
/INPUT_B: U1.5 (3_LRCLK2)
/INPUT_C: U1.6 (4_BCLK2)
/INPUT_D: U1.2 (0_RX1_CRX2_CS1)
/VCC: J3.2, P3.2, Q2.1 (C)
GND: C1.2, C4.1, J1.1, J4.3, J5.3, J6.3, J7.1, J8.1, J9.1, J10.1, J11.1, J12.2, J16.2, J17.1, P3.1, P4.1, P4.8, R3.2, R5.2, R6.2, RV1.1, RV2.1, RV3.1, U1.1 (GND), U2.1 (ADJ/GND)
unnamed: C2.1, RV2.2
unnamed: C3.1, RV1.2
unnamed: C5.1, RV3.2
unnamed: D1.1 (K), R3.1
unnamed: J1.2, J2.1
unnamed: J3.1, Q2.2 (B), R5.1
unnamed: J4.2, J5.2, J6.2
unnamed: C3.2, J7.2
unnamed: C2.2, J9.2
unnamed: J2.2, J8.2, J10.2, U2.3 (IN)
unnamed: J11.2, J13.1
unnamed: J12.1, J14.1
unnamed: J16.1, RV1.3
unnamed: C5.2, J17.2
unnamed: JP1.1 (A), Q2.3 (E), R6.1
unnamed: JP1.2 (C), P4.7
unnamed: U1.9 (7_RX2_OUT1A), U3.3 (DIN)
unnamed: U1.27 (20_A6_TX5_LRCLK1), U3.4 (LRCK)
unnamed: U1.28 (21_A7_RX5_BCLK1), U3.2 (BCK)
unnamed: C1.1, C4.2, U2.2 (OUT)

Notes on the sheet:
2 X KEMO amplifier 18W
AUXILIARY
INPUT AMPLI LEFT
OUPUT VOLTAGE 5V
VOLUME
INPUT AMPLI RIGHT
(SBUS)
NEXT
POWER CONNECTOR
RC CONNECTORS
PREVIOUS
VOLTAGE RANGE 7.2V -> 15v
HW COMMANDS

Board: 2 copper layers, 38 parts (1 on the bottom side), 22 nets, no tracks yet.
