pierrotm777/SoundModule_Teensy4.0-version/(commit log)

2025-02-10 Add first Kicad PCB
    [Sound_Myca_Teensy.kicad_pcb, Sound_Myca_Teensy.kicad_sch]
2025-03-02 Update Kicad files
    [Sound_Myca_Teensy.kicad_pcb, Sound_Myca_Teensy.kicad_sch]
2025-03-02 Add doc, 10 buttons keyboard and kemo
2025-03-02 update
    - add buttons page
    - update main README.md file
2025-03-02 Updates
    - update kicad files
    - add gerber v1.0
    - add bom
2025-03-10 rename first pcb to v1.0
2025-03-11 add wire info
2025-03-14 add bom
2025-03-15 add divider on pin 15
2025-03-26 update pcb
2025-03-26 add gerber and bom
2025-04-11 update mod lipo add
2025-04-14 update xany tests
    [RculXanyTests_V0.ods]
2025-04-17 update top and bom
2025-04-24 add alarms sounds
    [RculXanyTests_V1.ods]
2025-04-24 add wiring
2025-04-25 update exel file
    [RculXanyTests_V1.ods]
2025-04-29 add power
2025-05-25 update Rcul tests
    [RculXanyTests_V1.ods]
2025-12-18 Update v1.3 board
2025-12-19 Create Modify Tank Power.png
2025-12-20 add 18b20 wiring
2025-12-20 add ds18b20 to teensy
2026-02-15 update RCUL table
    [RculXanyTests_V1.ods]
2026-05-07 Add Radiomaster ER8
    [RculXanyTests_V1.ods]
